ryood/AD9833_FG/IMG_20170809_194404.jpg

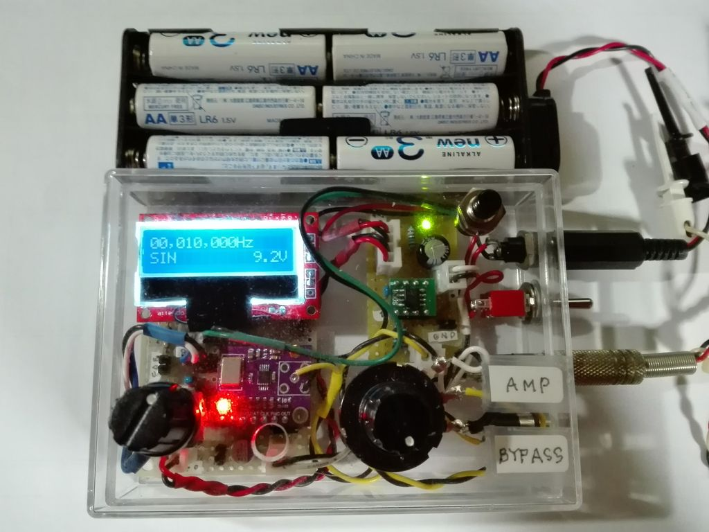
IMG_20170809_194404.jpg
