ryood/AD9833_FG/IMG_20170810_205447.jpg

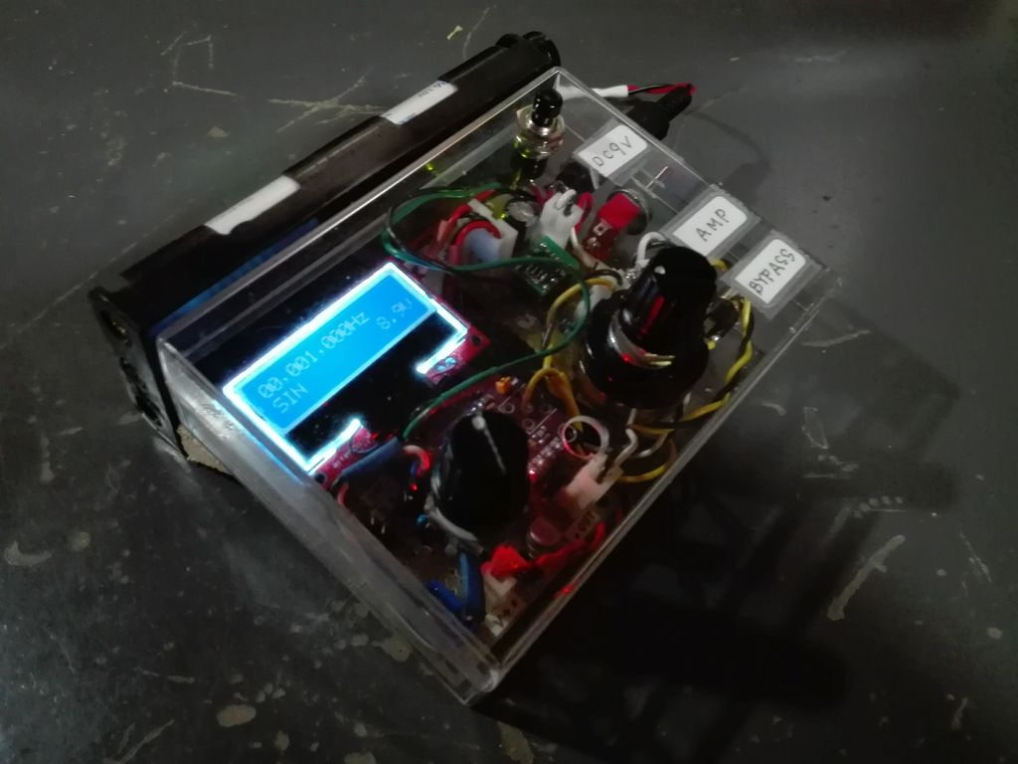
IMG_20170810_205447.jpg
