ryood/AD9833_FG/AD9833_FG_ケース内配線_ブレッドボード.png

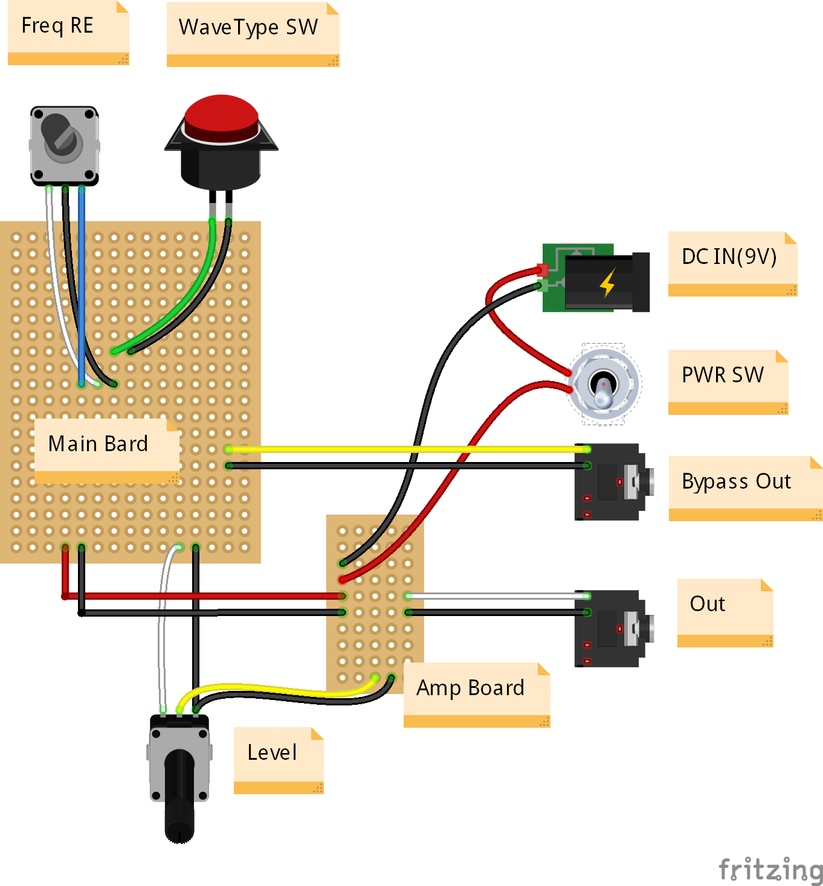
AD9833_FG_ケース内配線_ブレッドボード.png
