ryood/AD9833_FG/eagle/AD9833_FG_Main_brd.png

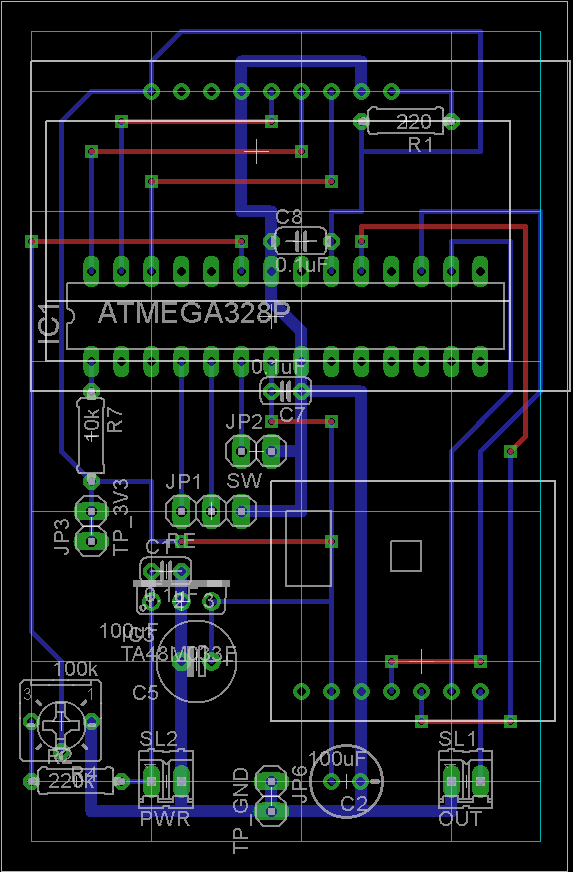
eagle/AD9833_FG_Main_brd.png
