ryood/AD9833_FG/eagle/AD9833_FG_Out_sch.png

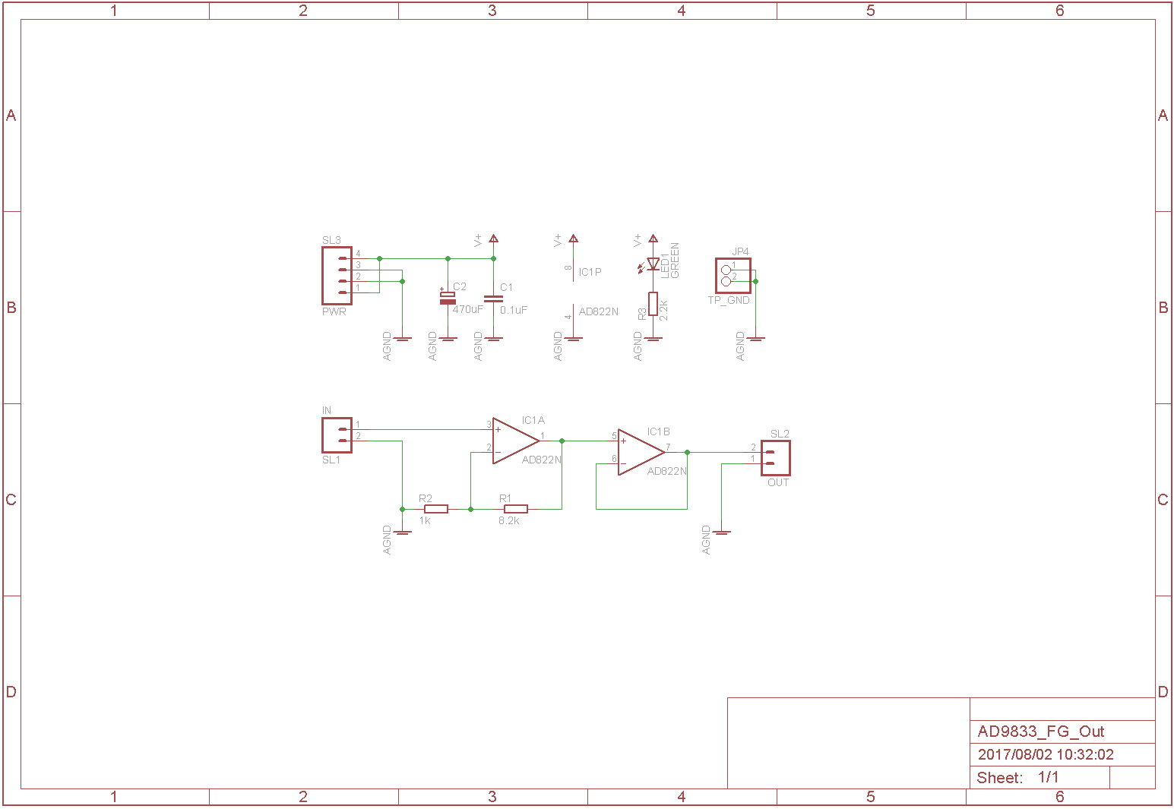
eagle/AD9833_FG_Out_sch.png
