ryood/AD9833_FG/(list of files, cad)

Other CAD files:
Case/AD9833_FG_Case.dwg
