ryood/AD9833_FG/spice/AD8933_3rdLPF.asc

C1: cap; 22pF
C2: cap; 33pF
C3: cap; 22pF
C4: cap; 22pF
C5: cap; 1pF
C6: cap; 5.6pF
C7: cap; 4.7pF
L1: ind; 470nH
L2: ind; 390nF
L3: ind; 390nH
R1: res; 200
V1: voltage; ""; AC 0.6
Named nets: 0, OUT, IN
