ryood/AD9833_FG/spice/AD9833_Amp.asc

R1: res; 3k
R2: res; 1k
U1: opamp2; NJM13404_ME
V1: voltage; 5
V2: voltage; SINE(0.3 0.3 1k); AC 0.6
Named nets: 0, VCC, OUT
.tran 1m
;ac oct 20 10 100Meg
.include mylib\
jm13404_2.lib
