ryood/AD9833_FG/(list of files, drawings)

Other design files:
fritzing/AD9833_FG_Main_3V3_TA48033F_Test.fzz
fritzing/AD9833_FG_Main_3V3_Test.fzz
fritzing/AD9833_FG_Main_Test.fzz
fritzing/AD9833_FG_Test.fzz
fritzing/AD9833_FG_ケース内配線.fzz
fritzing/AD9833_UART_Test.fzz
fritzing/Untitled Sketch.fzz
