ryood/AD9833_FG/eagle/AD9833_FG/AD9833_FG_Main_3V3.brd

## EAGLE design eagle/AD9833_FG/AD9833_FG_Main_3V3.brd (2017-08-09)

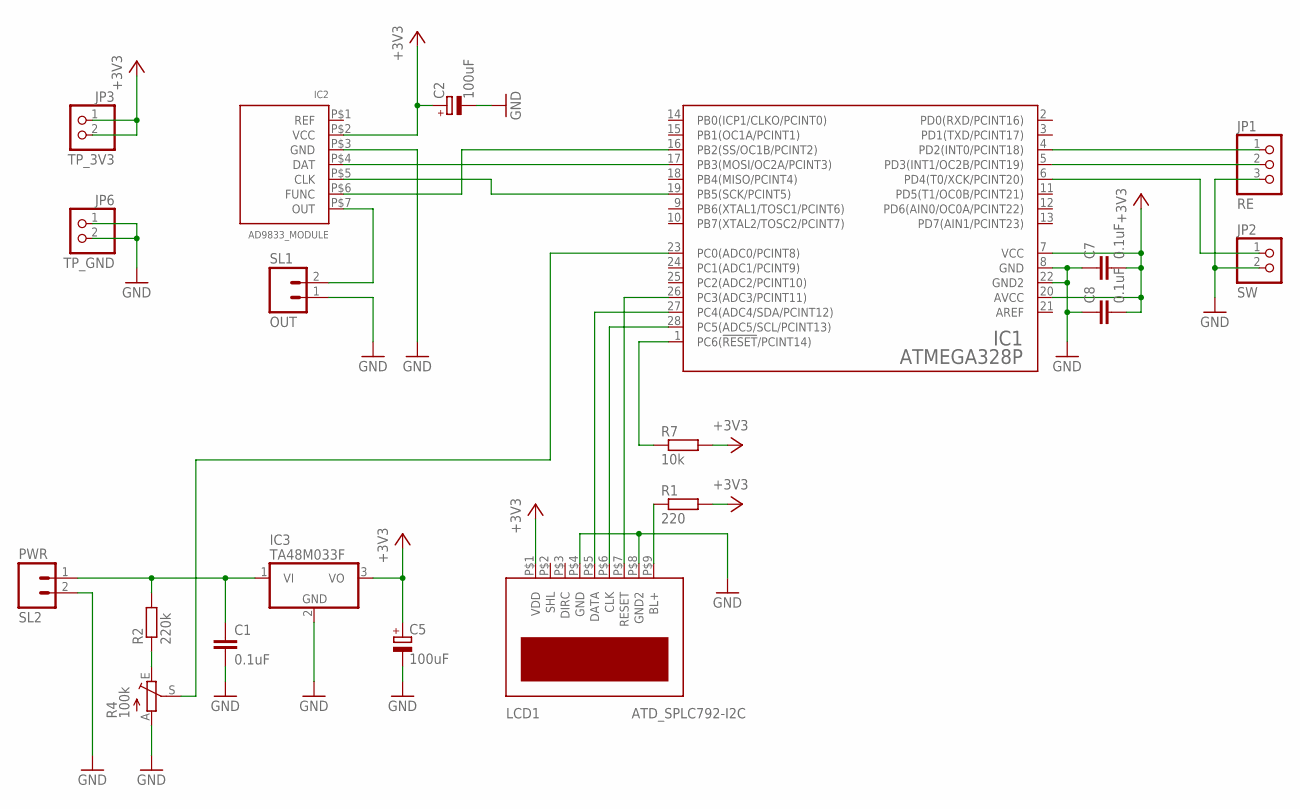
[picture p8: schematic AD9833_FG_Main_3V3.sch]

Parts:
C1, C7: 0.1uF; C025-024X044
C2: 100uF; SANYO-OSCON_C
C5: 100uF; E2,5-7
C8: 0.1uF; C050-024X044
IC1: ATMEGA328P; DIL28-3
IC2: AD9833_MODULE
IC3: TA48M033F; TA48MXXX
JP1: RE; 1X03
JP2: SW; 1X02
JP3: TP_3V3; 1X02
JP6: TP_GND; 1X02
LCD1: ATD_SPLC792-I2C
R1: 220; 0207/7
R2: 220k; 0207/7
R4: 100k; B25P
R7: 10k; 0207/7
SL1: OUT; 02P
SL2: PWR; 02P

Connections:
+3V3: C2.+, C5.+, C7.2, C8.2, IC1.7 (VCC), IC1.20 (AVCC), IC2.P$2 (VCC), IC3.3 (VO), JP3.1, JP3.2, LCD1.P$1 (VDD), R1.2, R7.2
GND: C1.2, C2.-, C5.-, C7.1, C8.1, IC1.8 (GND), IC1.22 (GND2), IC2.P$3 (GND), IC3.2 (GND), JP1.3, JP2.2, JP6.1, JP6.2, LCD1.P$4 (GND), LCD1.P$8 (GND2), R4.A, SL1.1, SL2.2
unnamed: IC1.17 (PB3(MOSI/OC2A/PCINT3)), IC2.P$4 (DAT)
unnamed: IC1.19 (PB5(SCK/PCINT5)), IC2.P$5 (CLK)
unnamed: IC1.16 (PB2(SS/OC1B/PCINT2)), IC2.P$6 (FUNC)
unnamed: IC1.28 (PC5(ADC5/SCL/PCINT13)), LCD1.P$6 (CLK)
unnamed: IC1.27 (PC4(ADC4/SDA/PCINT12)), LCD1.P$5 (DATA)
unnamed: IC2.P$7 (OUT), SL1.2
unnamed: IC1.26 (PC3(ADC3/PCINT11)), LCD1.P$7 (RESET)
unnamed: IC1.4 (PD2(INT0/PCINT18)), JP1.1
unnamed: IC1.5 (PD3(INT1/OC2B/PCINT19)), JP1.2
unnamed: IC1.6 (PD4(T0/XCK/PCINT20)), JP2.1
unnamed: R2.1, R4.E
unnamed: LCD1.P$9 (BL+), R1.1
unnamed: C1.1, IC3.1 (VI), R2.2, SL2.1
unnamed: IC1.23 (PC0(ADC0/PCINT8)), R4.S
unnamed: IC1.1 (PC6(!RESET!/PCINT14)), R7.1

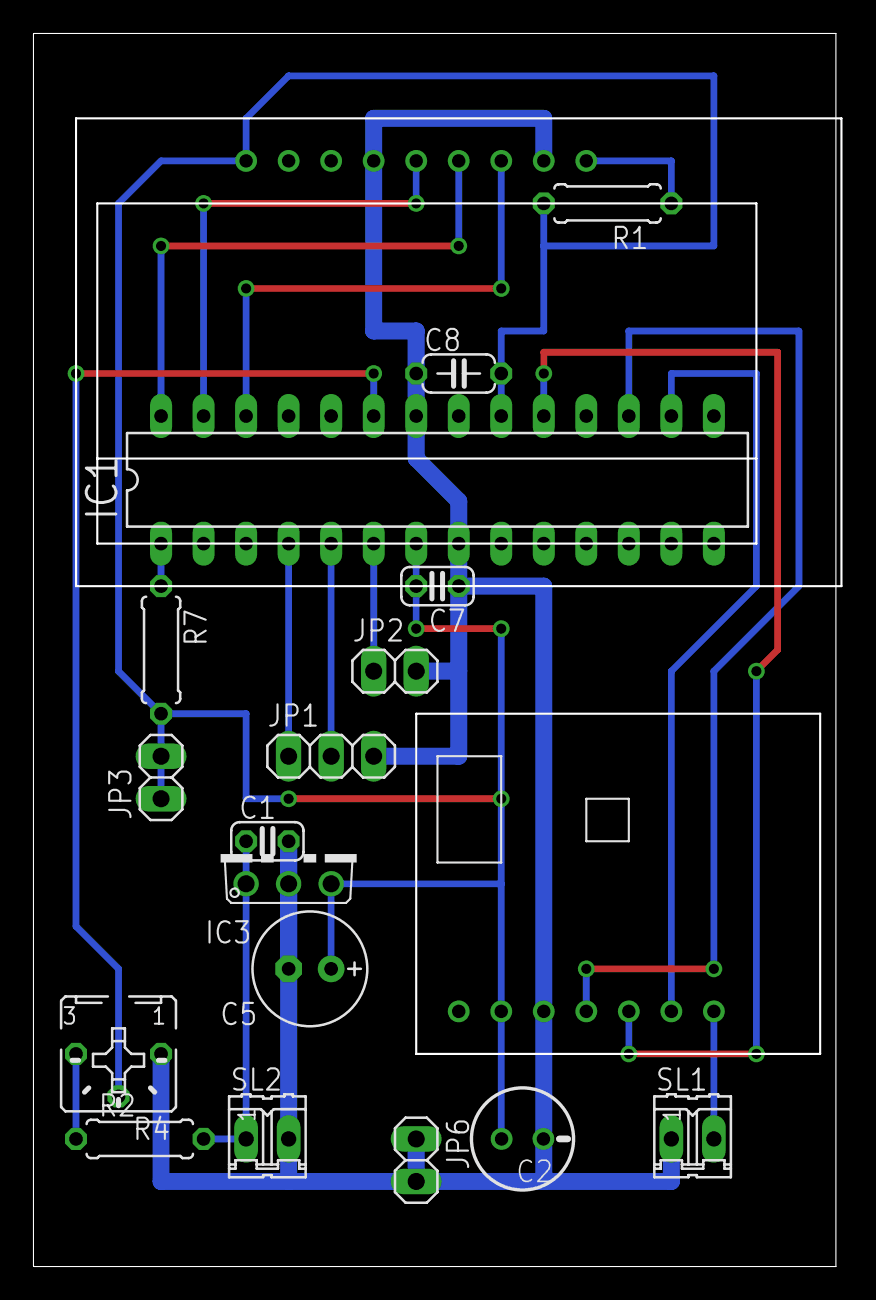
[picture p9: board AD9833_FG_Main_3V3.brd from above]

Board: 2 copper layers, 47.9 x 73.7 mm, 19 parts (0 on the bottom side), 17 nets.
