ryood/AD9833_FG/eagle/AD9833_FG/AD9833_FG_Out.brd

## EAGLE design eagle/AD9833_FG/AD9833_FG_Out.brd (2017-08-06)

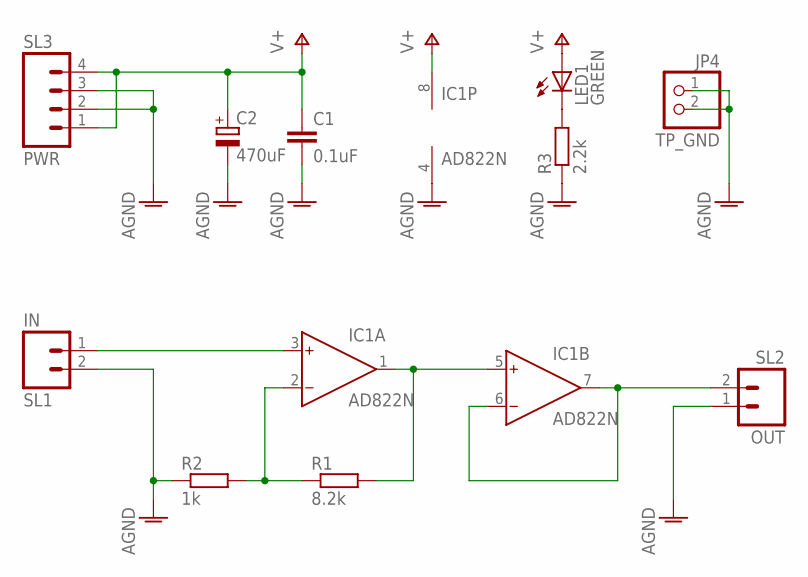
[picture p10: schematic AD9833_FG_Out.sch]

Parts:
C1: 0.1uF; C025-024X044
C2: 470uF; E2,5-7
IC1: AD822N; DIL08
JP4: TP_GND; 1X02
LED1: GREEN; LED3MM
R1: 8.2k; 0207/7
R2: 1k; 0207/7
R3: 2.2k; 0207/7
SL1: IN; 02P
SL2: OUT; 02P
SL3: PWR; 04P

Connections:
AGND: C1.2, C2.-, IC1.4 (V-), JP4.1, JP4.2, R2.1, R3.1, SL1.2, SL2.1, SL3.2, SL3.3
unnamed: IC1.2 (IN-), R1.1, R2.2
unnamed: IC1.3 (IN+), SL1.1
unnamed: IC1.1 (OUT), IC1.5 (IN+), R1.2
unnamed: IC1.6 (IN-), IC1.7 (OUT), SL2.2
unnamed: LED1.K (C), R3.2
V+: C1.1, C2.+, IC1.8 (V+), LED1.A, SL3.1, SL3.4

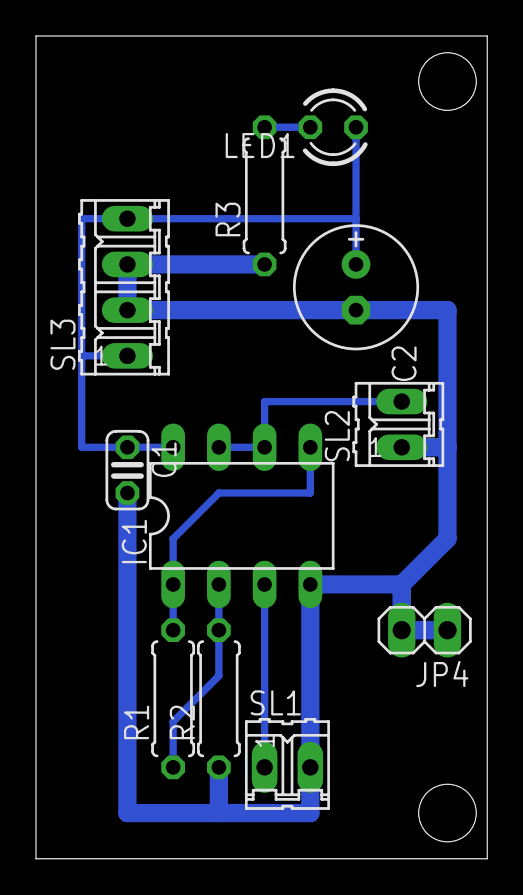
[picture p11: board AD9833_FG_Out.brd from above]

Board: 2 copper layers, 25.1 x 45.7 mm, 11 parts (0 on the bottom side), 7 nets.
