ryood/AD9833_FG/fritzing/AD9833_FG_Main_3V3_TA48033F_Test_ブレッドボード.png

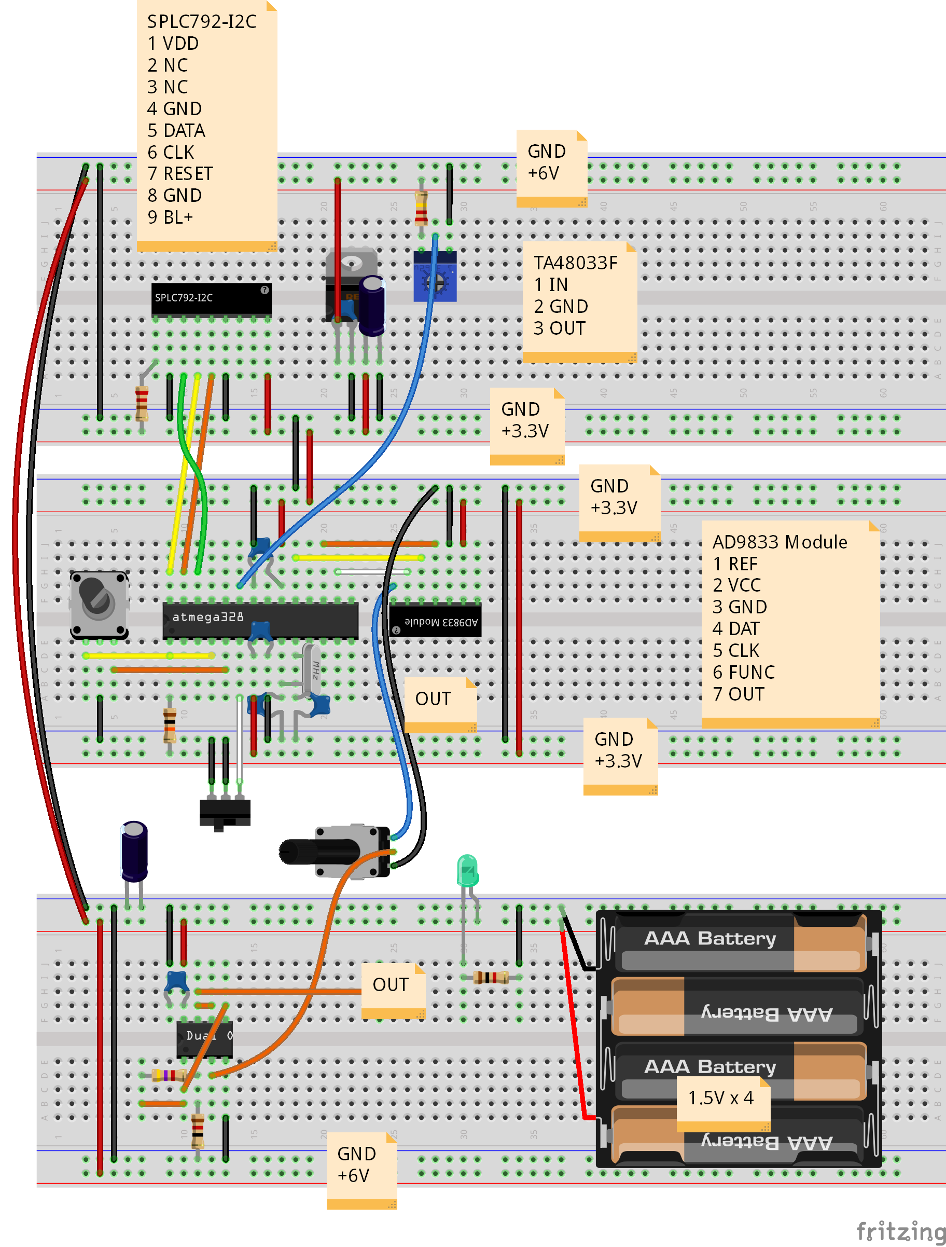
fritzing/AD9833_FG_Main_3V3_TA48033F_Test_ブレッドボード.png
