ryood/AD9833_FG/fritzing/AD9833_FG_Test_ブレッドボード.png

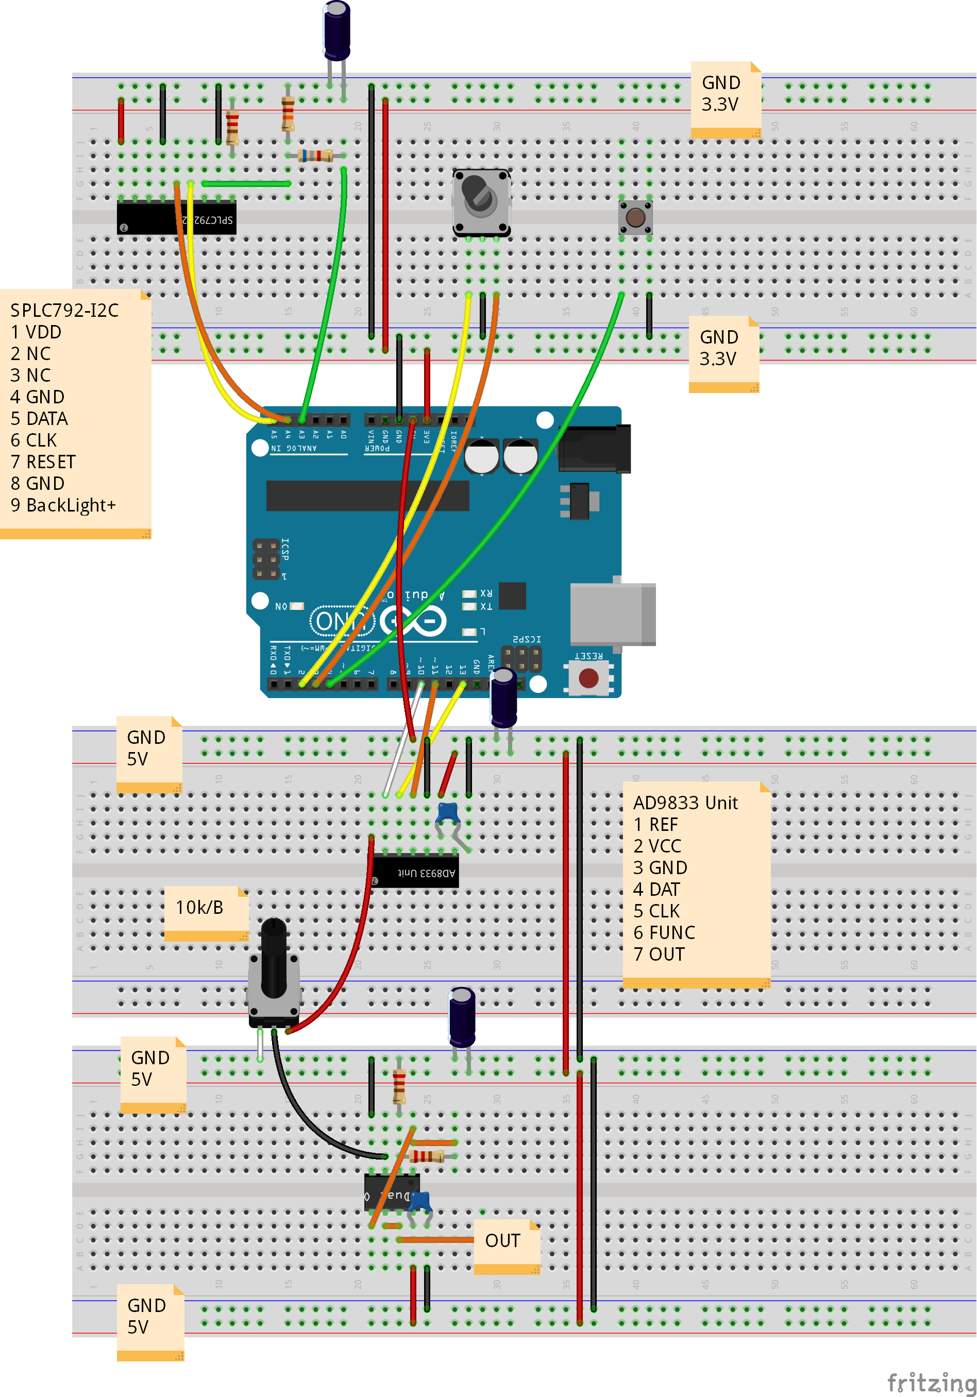
fritzing/AD9833_FG_Test_ブレッドボード.png
