ryood/AD9833_FG/fritzing/AD9833_UART_Test_ブレッドボード.png

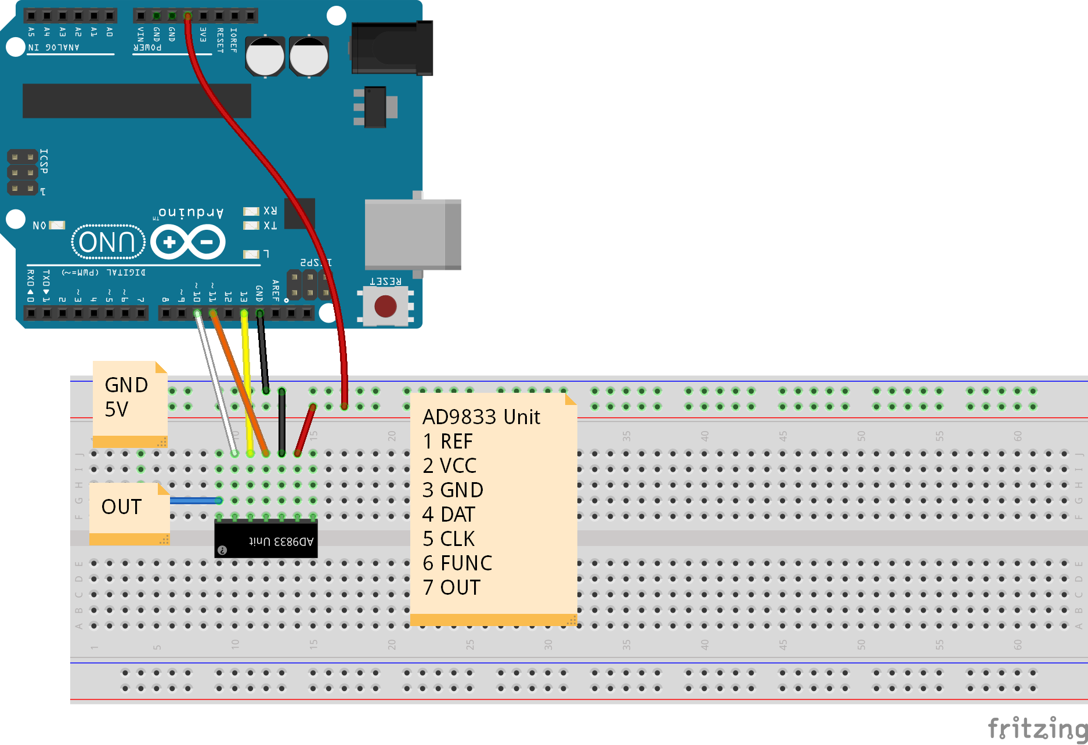
fritzing/AD9833_UART_Test_ブレッドボード.png
