ryood/AD9833_FG/Arduino/AD9833_FG/AD9833_FG.ino

#include <SPI.h>
#include <Wire.h>
#include <EEPROM.h>
#include <stdio.h>

#define UART_TRACE  (0) // UARTにデバッグ情報を出力する場合は1にする。
#define CLOCK_8MHZ  (0) // 8MHz駆動する場合1にする。

#define TITLE_STR1  ("AD9833 FG")
#define TITLE_STR2  ("20181031")

#define BATTERY_CHECK_CYCLE (1000)

//--------------------------------------------------------------------------------
// pin assign
//

// AD8933
const int FSYNC = 10;                       // Standard SPI pins for the AD9833 waveform generator.
const int CLK = 13;
const int DATA = 11;

// Rotary Encoder
const int RE_A = 2;
const int RE_B = 3;

// Tact SW
const int SW1 = 4;

// I2C LCD
const int resetPin = 17;  // analog pin 3
const int sdaPin = 18;    // analog pin 4
const int sclPin = 19;    // analog pin 5
const int i2cadr = 0x3e;
const byte contrast = 50; // 最初は大きめにして調整する

// Battery Check
const int batteryPin = 0; // analog pin 0 (0..1.1V)

//--------------------------------------------------------------------------------
// constants
//

const float refFreq = 25000000.0;           // On-board crystal reference frequency

// Wave Form
const int wfSine     = 0;
const int wfTriangle = 1;
const int wfIndexMax = 2;

// mask of AD9833 Control Register
const uint16_t waveFormTable[] = {
  0x2000, // Sine
  0x2002  // Triangle
};

const char waveFormName[][20] = {
  "SIN     ",
  "TRI     "  
};

const uint32_t frequencyTable[] = {  
  1,
  2,
  3,
  4,
  5,
  6,
  7,
  8,
  9,
  10,
  12,
  15,
  20,
  25,
  30,
  40,
  50,
  60,
  70,
  80,
  90,
  100,
  120,
  150,
  200,
  250,
  300,
  400,
  500,
  600,
  700,
  800,
  900,
  1000,
  1200,
  1500,
  2000,
  2500,
  3000,
  4000,
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
};

const int frequencyIndexMax = (sizeof(frequencyTable) / sizeof(uint32_t));

//--------------------------------------------------------------------------------
// Variables
//

int frequencyIndex = 33; // 1kHz
int waveFormIndex = 0;  // Sine wave

int prevFrequencyIndex = -1;
int prevWaveFormIndex = -1;

uint16_t batteryCheckCnt = 04;

const char strBuffer[80];

//--------------------------------------------------------------------------------
// Main routins
//
void setup() {
  pinMode(RE_A, INPUT_PULLUP);
  pinMode(RE_B, INPUT_PULLUP);
  pinMode(SW1, INPUT_PULLUP);

#if UART_TRACE
  Serial.begin(9600);
  Serial.println("AD9833 UI Test.");
  sprintf(strBuffer, "%s %s", TITLE_STR1, TITLE_STR2);
  Serial.println(strBuffer);
  my_delay(1000);  
#endif

  // I2C LCD
  lcd_init();
  lcd_puts(TITLE_STR1);
  //lcd_move(0x40);
  lcd_pos(1, 1);
  lcd_puts(TITLE_STR2);
  my_delay(1000);

  // EEPROMからパラメータを読み込み
  eeLoadParams();

  // AD8933
  SPI.begin();
  SPI.setDataMode(SPI_MODE2);
  my_delay(50);

  AD9833reset();
  my_delay(50);
  AD9833setFrequency(frequencyTable[frequencyIndex], waveFormTable[wfSine]);
}

void loop()
{  
  readParams();

#if UART_TRACE
  displayParamsSerial(frequency, waveForm);
#endif

  if (frequencyIndex != prevFrequencyIndex || waveFormIndex != prevWaveFormIndex) {
    uint32_t frequency = frequencyTable[frequencyIndex];
    int waveForm = waveFormTable[waveFormIndex];
  
    prevFrequencyIndex = frequencyIndex;
    prevWaveFormIndex = waveFormIndex;

    // LCDに表示
    displayParamsI2CLCD(frequency, waveFormIndex);

    // AD9833に出力
    AD9833setFrequency(frequencyTable[frequencyIndex], waveFormTable[waveFormIndex]);

    // EEPROMに保存
    eeStoreParams();
  }

  // 電源電圧チェック
  if (batteryCheckCnt == 0) {
    batteryCheckCnt = BATTERY_CHECK_CYCLE;
    checkBattery();
  }
  batteryCheckCnt--;
}

//--------------------------------------------------------------------------------
// Utility
//
void my_delay(unsigned long ms) {
#if CLOCK_8MHZ
  delay(ms / 2 + 1);
#else
  delay(ms);
#endif
}

//--------------------------------------------------------------------------------
// UI Input functions
//
void readParams()
{
  // 周波数設定 Rotary Encoderの読み取り
  frequencyIndex += readRE();
  if (frequencyIndex <= 0) {
    frequencyIndex = 0;
  }
  else if (frequencyIndex >= frequencyIndexMax) {
    frequencyIndex = frequencyIndexMax - 1;
  }

  /*
  // 波形設定SWの読み取り (トグルスイッチ)
  if (digitalRead(SW1) == LOW) {
    waveFormIndex = 0;
  }
  else {
    waveFormIndex = 1;
  }
  */
  
  // 波形設定SWの読み取り (タクトスイッチ)
  if (digitalRead(SW1) == LOW) {
    waveFormIndex++;
    if (waveFormIndex >= wfIndexMax) {
      waveFormIndex = 0;  // wfSine;
    }
    my_delay(200); // (とりあえず)チャタリング防止
  }
}

// Rotary Encoderの読み取り akizuki/Alps
int readRE()
{
  static uint8_t index;
  int retVal = 0;
  index = (index << 2) | (digitalRead(RE_B) << 1) | (digitalRead(RE_A));
  index &= 0b1111;
  switch (index) {
  // 時計回り
  case 0b0111:  // 01 -> 11
    retVal = 1;
    break;
  // 反時計回り
  case 0b1101:  // 11 -> 01
    retVal = -1;
    break;
  }
  my_delay(1);  // (とりあえず)チャタリング防止
  return retVal;
}

//--------------------------------------------------------------------------------
// UI Display functions
//
#if UART_TRACE
void displayParamsSerial(uint32_t frequency, int waveForm)
{
  Serial.print(waveFormIndex);
  Serial.print('\t');
  Serial.print("0x");
  Serial.print(waveForm, HEX);

  Serial.print('\t');
  
  Serial.print(frequencyIndex);
  Serial.print('\t');
  Serial.println(frequency);  
}
#endif

void displayParamsI2CLCD(uint32_t frequency, int waveFormIndex)
{
  //lcd_clear();

  // 周波数表示
  int million = frequency / 1000000;
  int thouthand = (frequency - million * 1000000) / 1000;
  int one = frequency - million * 1000000 - thouthand * 1000; 
  lcd_pos(0, 0);
  sprintf(strBuffer, "%02d,%03d,%03dHz", million, thouthand, one);
  lcd_puts(strBuffer);

  // 波形表示
  lcd_pos(1, 0);
  lcd_puts(waveFormName[waveFormIndex]);
}

//--------------------------------------------------------------------------------
// I2C LCD: akizuki AQM0802 / aitendo SPLC792-I2C
//
void lcd_cmd(byte x)
{
  Wire.beginTransmission(i2cadr);
  Wire.write(0x00);
  Wire.write(x);
  Wire.endTransmission();
}

void lcd_data(byte x)
{
  Wire.beginTransmission(i2cadr);
  Wire.write(0x40);
  Wire.write(x);
  Wire.endTransmission();
}

void lcd_puts(const char *s)
{
  while(*s) lcd_data(*s++);
}

void lcd_init()
{
  // reset
  my_delay(500);
  pinMode(resetPin, OUTPUT);
  digitalWrite(resetPin, LOW);
  my_delay(1);
  digitalWrite(resetPin, HIGH);
  my_delay(10);
  // LCD initialize
  my_delay(40);
  Wire.begin();
  lcd_cmd(0x38); // function set
  lcd_cmd(0x39); // function set
  lcd_cmd(0x14); // interval osc
  lcd_cmd(0x70 | (contrast & 15)); // contrast low
  lcd_cmd(0x5c | (contrast >> 4 & 3)); // contrast high / icon / power
  lcd_cmd(0x6c); // follower control
  my_delay(300);
  lcd_cmd(0x38); // function set
  lcd_cmd(0x0c); // display on
  lcd_cmd(0x01); // clear display
  my_delay(2);
}

/*
void lcd_move(byte pos){
  lcd_cmd(0x80 | pos);
}
*/

void lcd_pos(byte raw, byte col) {
  lcd_cmd(0x80 | ((raw & 0x01) << 6) | col);
}

void lcd_clear() {
  lcd_cmd(0x01);
}

//--------------------------------------------------------------------------------
// AD9833: Waveform Generator
//

// AD9833 documentation advises a 'Reset' on first applying power.
void AD9833reset() {
  WriteRegister(0x100);   // Write '1' to AD9833 Control register bit D8.
  my_delay(10);
}

// Set the frequency and waveform registers in the AD9833.
void AD9833setFrequency(long frequency, int Waveform) {

  long FreqWord = (frequency * pow(2, 28)) / refFreq;

  int MSB = (int)((FreqWord & 0xFFFC000) >> 14);    //Only lower 14 bits are used for data
  int LSB = (int)(FreqWord & 0x3FFF);

  //Set control bits 15 ande 14 to 0 and 1, respectively, for frequency register 0
  LSB |= 0x4000;
  MSB |= 0x4000;

  WriteRegister(0x2100);
  WriteRegister(LSB);                  // Write lower 16 bits to AD9833 registers
  WriteRegister(MSB);                  // Write upper 16 bits to AD9833 registers.
  WriteRegister(0xC000);               // Phase register
  WriteRegister(Waveform);             // Exit & Reset to SINE, SQUARE or TRIANGLE
}

void WriteRegister(int dat) {

  // Display and AD9833 use different SPI MODES so it has to be set for the AD9833 here.
  //SPI.setDataMode(SPI_MODE2);

  digitalWrite(FSYNC, LOW);           // Set FSYNC low before writing to AD9833 registers
  delayMicroseconds(10);              // Give AD9833 time to get ready to receive data.

  SPI.transfer(highByte(dat));        // Each AD9833 register is 32 bits wide and each 16
  SPI.transfer(lowByte(dat));         // bits has to be transferred as 2 x 8-bit bytes.

  digitalWrite(FSYNC, HIGH);          //Write done. Set FSYNC high
}

//--------------------------------------------------------------------------------
// EEPROM 
//
void eeStoreParams()
{
  int eeAddress = 0;
  EEPROM.put(eeAddress, frequencyIndex);
  eeAddress += sizeof(int);
  EEPROM.put(eeAddress, waveFormIndex);  
}

void eeLoadParams()
{
  int eeAddress = 0;
  EEPROM.get(eeAddress, frequencyIndex);
  constrain(frequencyIndex, 0, frequencyIndexMax - 1);
  eeAddress += sizeof(int);
  EEPROM.get(eeAddress, waveFormIndex);
  constrain(waveFormIndex, 0, wfIndexMax - 1);
}

//--------------------------------------------------------------------------------
// Battery Check
//
void checkBattery()
{
  analogReference(INTERNAL);
  
  int v = analogRead(batteryPin);
  float voltage = ((float)v / 1024.f) * 10.0f;

  int v_real    = (int)voltage;  // 整数部
  int v_decimal = (int)((voltage - v_real) * 10); // 小数部１桁
  
  //sprintf(strBuffer, "%4d %4d.%d\V%", v, v_real, v_decimal);
  //lcd_pos(1, 4);
  sprintf(strBuffer, "%5d.%dV", v_real, v_decimal);
  lcd_pos(1, 8);
  lcd_puts(strBuffer);
}
