ryood/AD9833_FG/(commit log)

2017-07-24 Impl: I2C LCD
2017-07-24 Debug: UI_Test: I2C-LCD
2017-07-24 AD9833_FG: 周波数刻みを増やした
2017-07-26 Update AD9833_FG.ino Add eagle & spice files
    [AD9833_FG_Test.fzz, AD9833_UART_Test.fzz, Untitled Sketch.fzz]
2017-07-27 AD9833_FG Impl. Battery Check
2017-07-27 AD9833_FG 波形選択用SWをタクトスイッチからトグルスイッチに変更
2017-07-28 Add eagle files
    [AD9833_FG_Main.brd, AD9833_FG_Main.sch, AD9833_FG_Out.sch]
2017-07-29 Update eagle files
    [AD9833_FG_Main.brd, AD9833_FG_Main.sch]
2017-07-29 Add ケース内配線
    [AD9833_FG_Main_Test.fzz, AD9833_FG_ケース内配線.fzz]
2017-07-29 3.3V Version
    [AD9833_FG_Main_3V3.sch, AD9833_FG_Main_3V3_TA48033F_Test.fzz, AD9833_FG_Main_3V3_Test.fzz]
2017-07-29 Board Design
    [AD9833_FG_Main_3V3.brd, AD9833_FG_Main_3V3.sch, AD9833_FG_Out.brd, AD9833_FG_Out.sch]
2017-07-30 Battery check -> percentage
    [AD9833_FG_Main_3V3_TA48033F_Test.fzz]
2017-08-06 Impl. Amp Board
    [AD9833_FG テスト表.xlsx, AD9833_FG_Case.dwg, AD9833_FG_Main_3V3.brd, AD9833_FG_Main_3V3.sch, AD9833_FG_Out.brd, AD9833_FG_Out.sch, AD9833_FG_ケース内配線.fzz]
